ffs97/ta202-iitk-project/README.md

# TA202-IITK-Project
TA202 IITK 4th Semester Project, based on Smart Car Parking. Project Files include Isometric and Part Drawings, Inventor Files and Final Report for the TA202 IITK Project.
