ffs97/ta202-iitk-project/(list of files, cad)

Other CAD files:
Inventor Project/Inventor Drawing Files/Main Support.dwg
Inventor Project/Inventor Drawing Files/Main Assembly.dwg
Inventor Project/Inventor Drawing Files/Sprocket Shaft.dwg
Inventor Project/Inventor Drawing Files/Bed Axle.dwg
Inventor Project/Inventor Drawing Files/Angle.dwg
Inventor Project/Inventor Drawing Files/Worm Support.dwg
Inventor Project/Inventor Drawing Files/Handle Frame.dwg
Inventor Project/Inventor Drawing Files/Bed Plate Support.dwg
Inventor Project/Inventor Drawing Files/Handle Fix.dwg
Inventor Project/Inventor Drawing Files/Base Plate.dwg
Inventor Project/Inventor Drawing Files/Handle Holder.dwg
Inventor Project/Inventor Drawing Files/Worm Shaft.dwg
Inventor Project/Inventor Drawing Files/Bed Plate Hang.dwg
Inventor Project/Inventor Drawing Files/Bed Plate.dwg
Inventor Project/Inventor Drawing Files/Ramp.dwg
Inventor Project/Inventor Drawing Files/OldVersions/Main Assembly.0001_1.dwg
Inventor Project/Inventor Drawing Files/OldVersions/Handle Fix.0001.dwg
Inventor Project/Inventor Drawing Files/OldVersions/Bed Plate Hang.0001.dwg
Inventor Project/Angle.ipt
Inventor Project/Base Plate.ipt
Inventor Project/Bed Plate Assembly.iam
Inventor Project/Bed Plate Axle.ipt
Inventor Project/Bed Plate Hang.ipt
Inventor Project/Bed Plate Support.ipt
Inventor Project/Bed Plate.ipt
Inventor Project/Chain.ipt
Inventor Project/Handle Assembly.iam
Inventor Project/Handle Connected.ipt
Inventor Project/Handle Fix.ipt
Inventor Project/Handle Holder.ipt
Inventor Project/Inventor Drawing Files/OldVersions/Bed Plate.0001.dwg
Inventor Project/Main Assembly.iam
Inventor Project/Main Support.ipt
Inventor Project/Ramp.ipt
Inventor Project/Sprocket Axle.ipt
Inventor Project/Sprocket.ipt
Inventor Project/Worm Axle.ipt
Inventor Project/Worm Gear.ipt
Inventor Project/Worm Support.ipt
Inventor Project/Worm.ipt
