ffs97/ta202-iitk-project/Drawings/Handle Fix.pdf

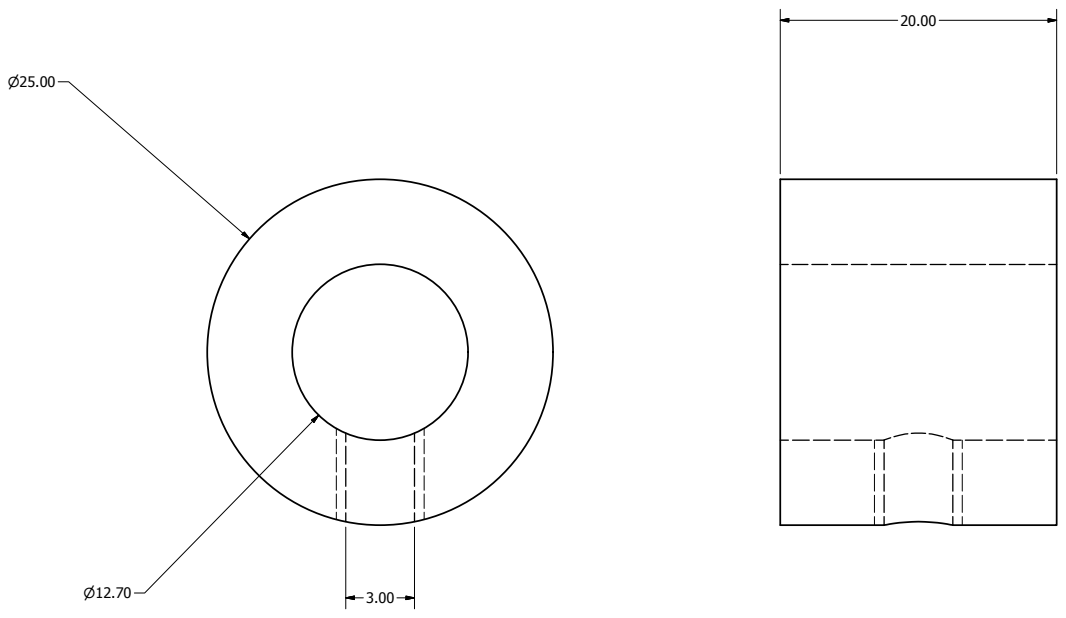
[picture p2: page 1]
Part No.; Quantity; Part Name; Handle Fix; Rod 22mm
