ffs97/ta202-iitk-project/Drawings/Bed Assembly.pdf

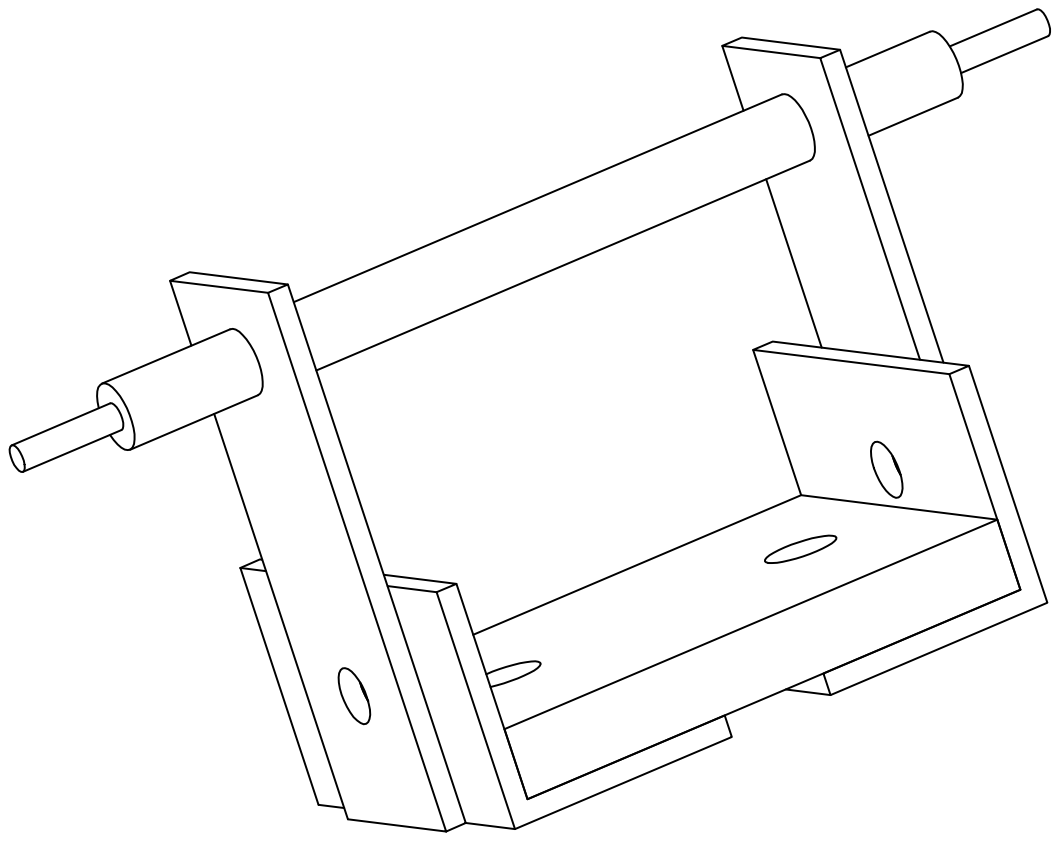
[picture p3: page 1]
Part No.; Quantity; Part Name; Bed Assembly
