ffs97/ta202-iitk-project/Drawings/Handle Assembly.pdf

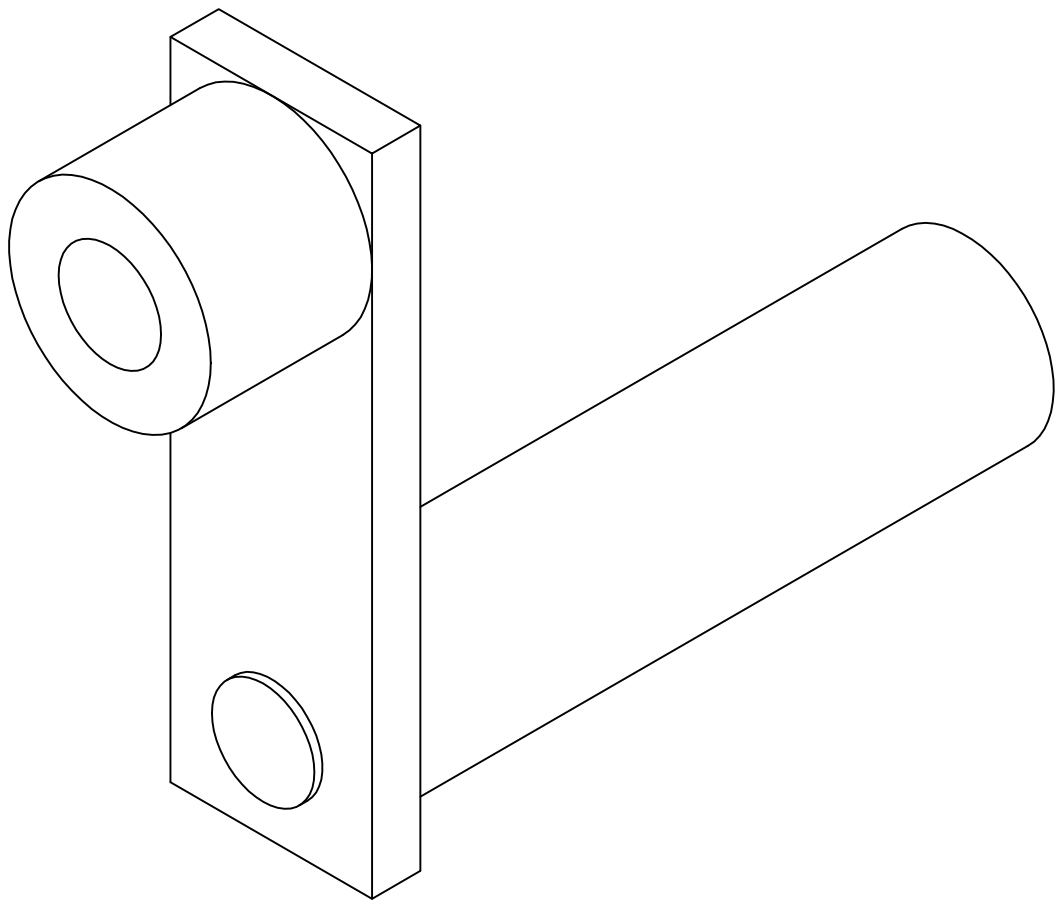
[picture p4: page 1]
Part No.; Quantity; Part Name; Handle Assembly
