ffs97/ta202-iitk-project/Drawings/Angle.pdf

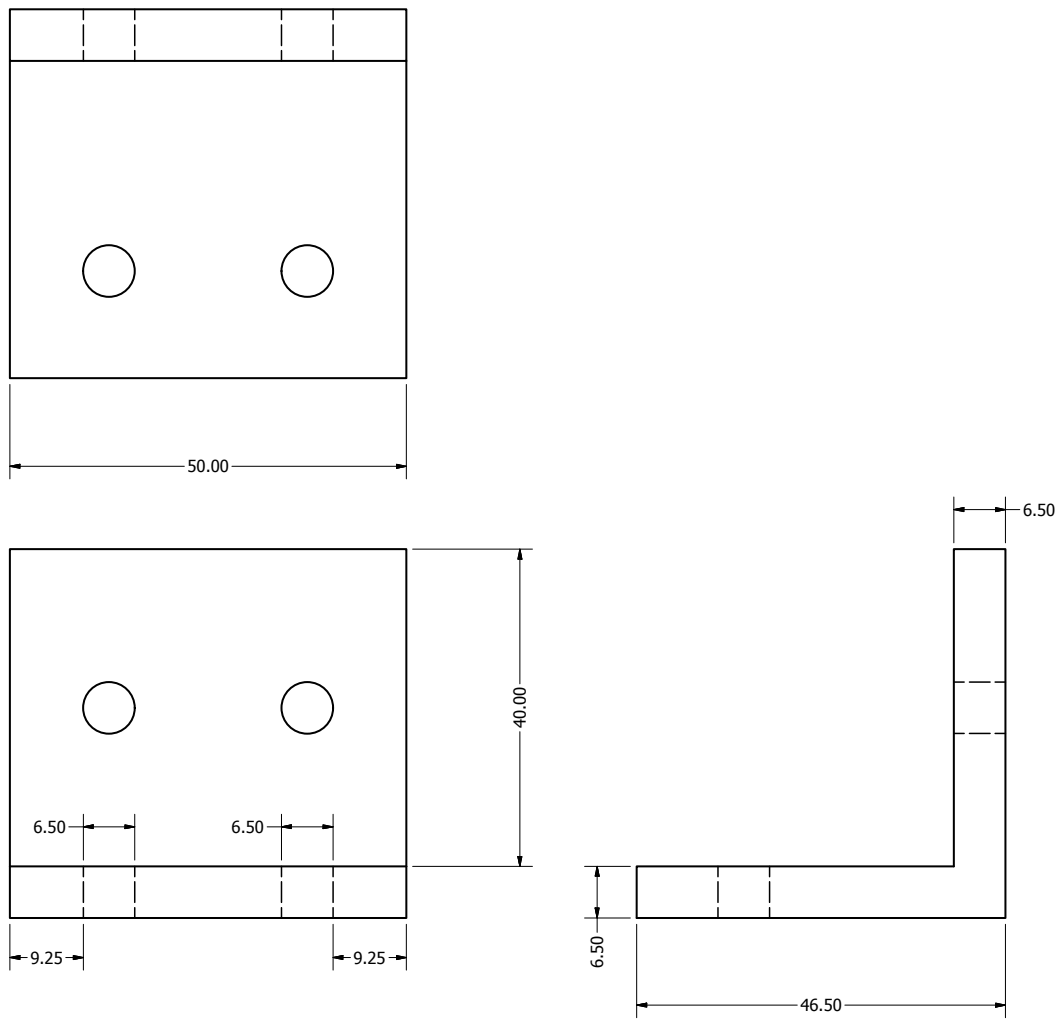
[picture p5: page 1]
Part No.; Quantity; Part Name; Angle; Flat 50mm x 50mm x
