ffs97/ta202-iitk-project/Drawings/Base Plate.pdf

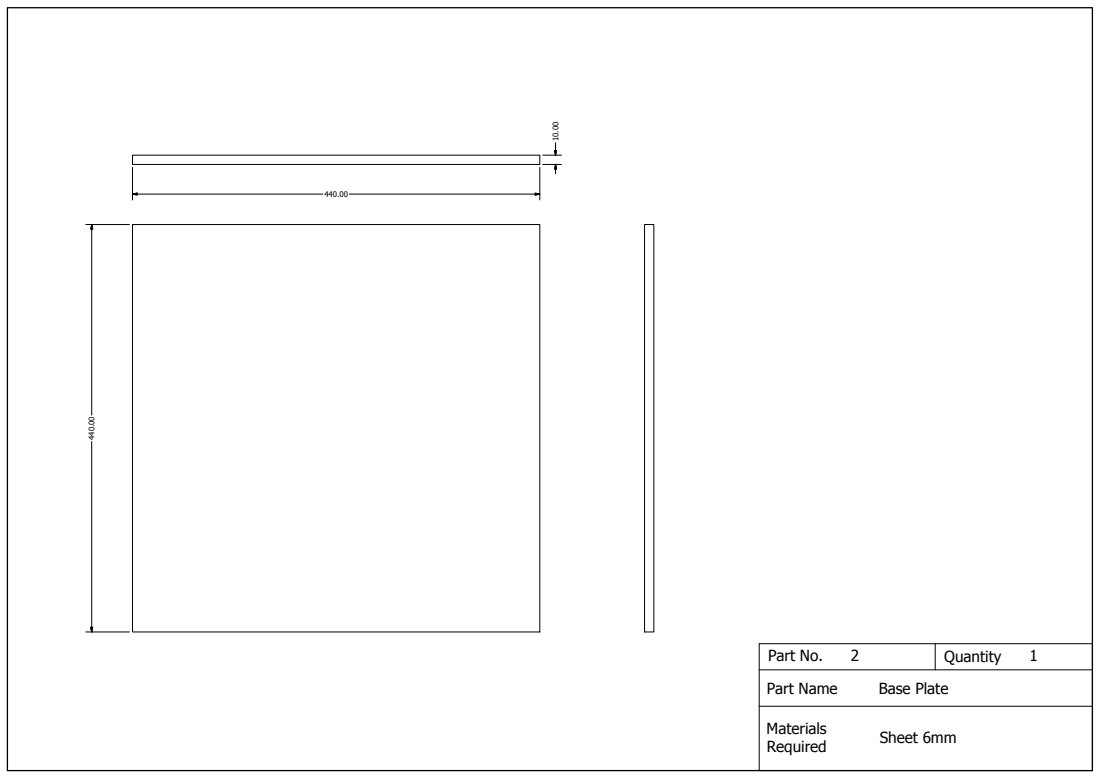
[picture p6: page 1]
Part No.; Quantity; Part Name; Base Plate; Sheet 6mm
