ffs97/ta202-iitk-project/Drawings/Bed Axle.pdf

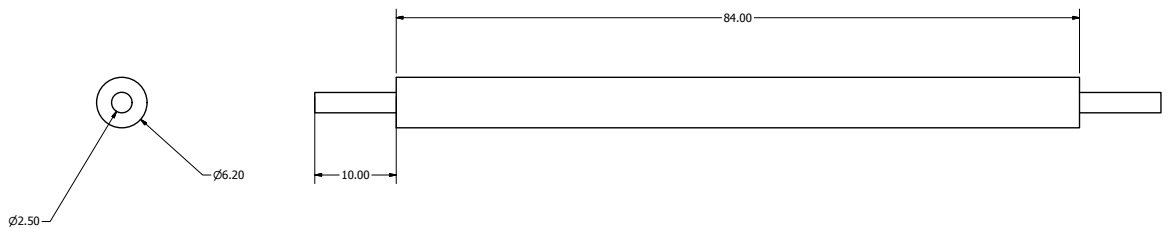
[picture p7: page 1]
Part No.; Quantity; Part Name; Bed Axle; Rod 6mm
