ffs97/ta202-iitk-project/Drawings/Bed Plate Hang.pdf

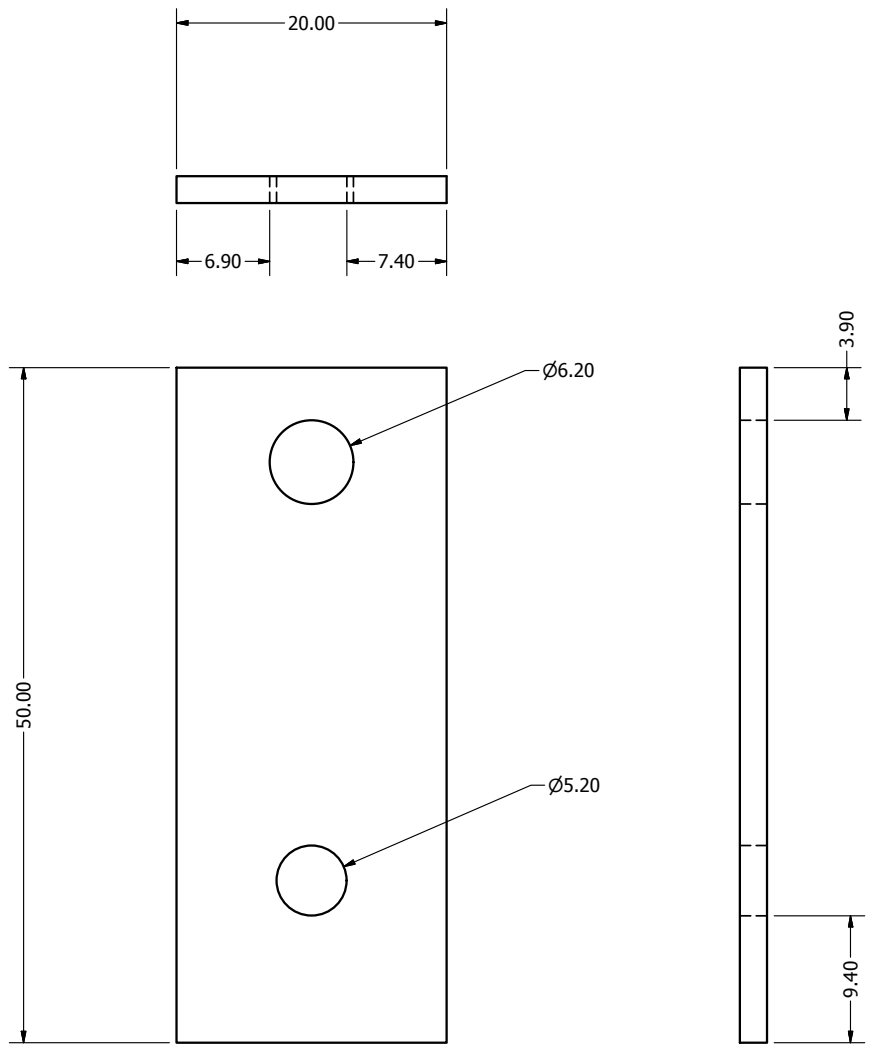
[picture p8: page 1]
Part No.; Quantity; Part Name; Bed Hang; Flat 2mm x 1mm
