ffs97/ta202-iitk-project/Drawings/Bed Plate Support.pdf

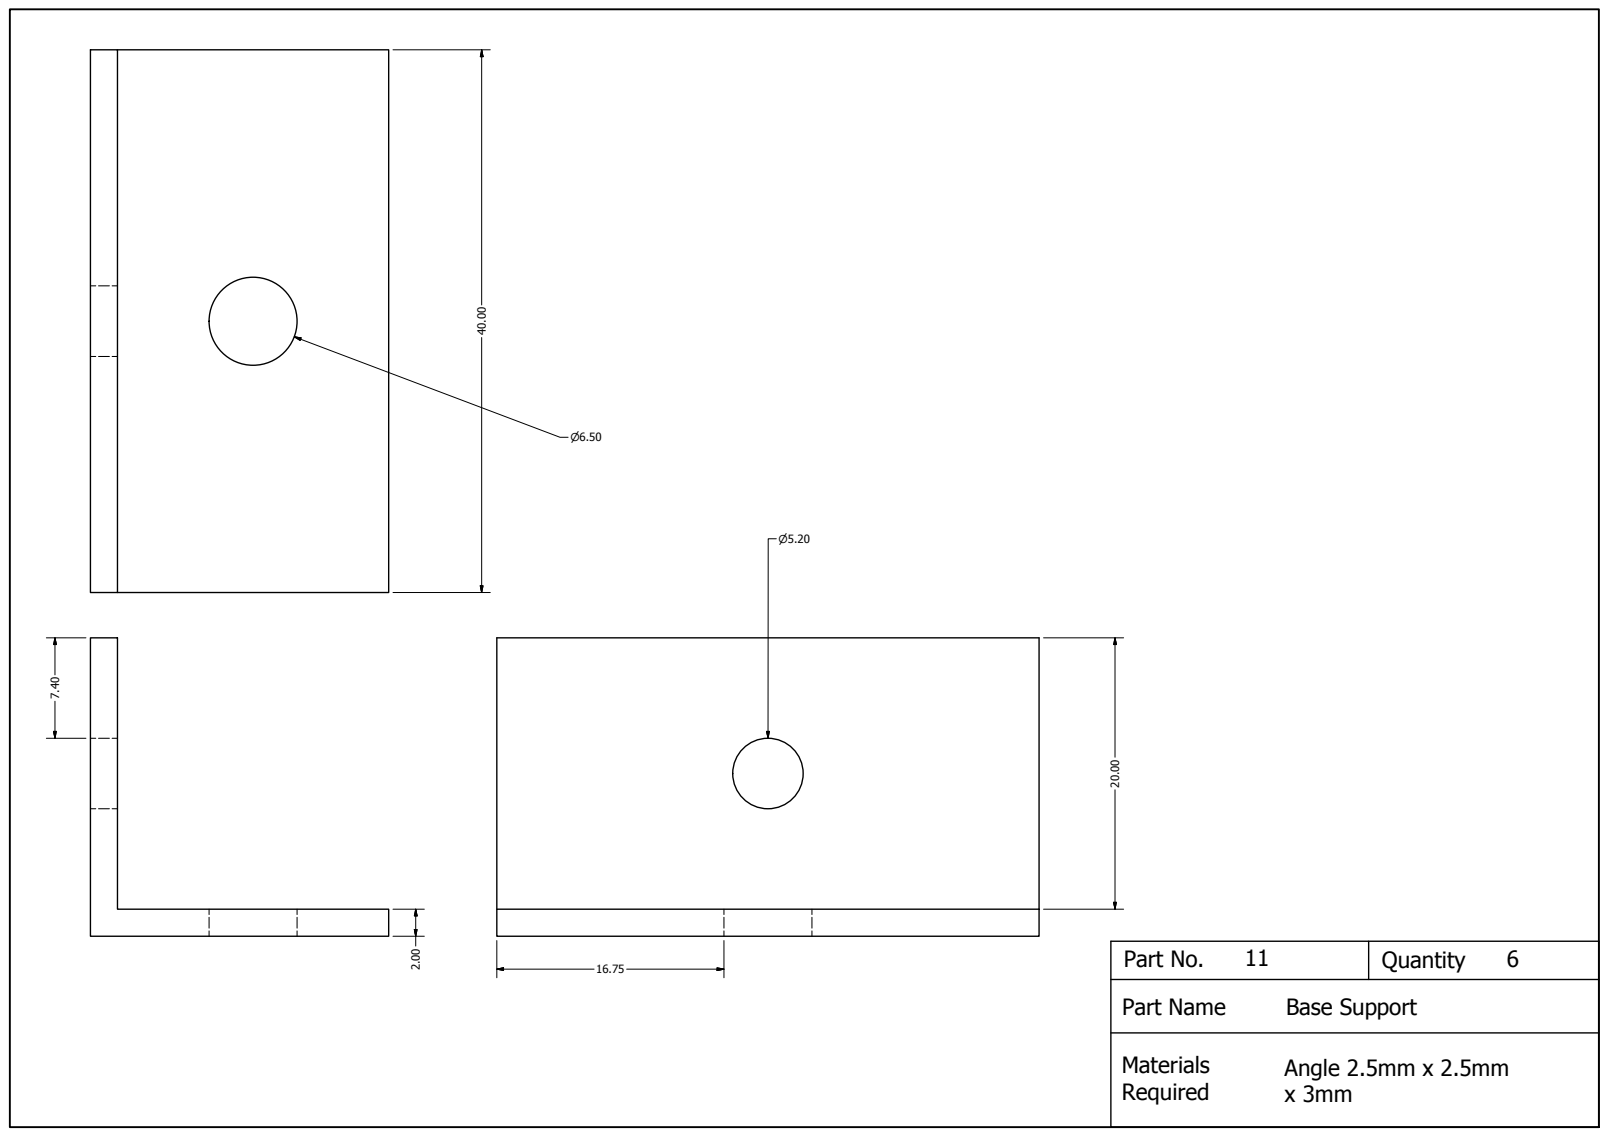
[picture p9: page 1]
Part No.; Quantity; Part Name; Base Support; Angle 2.5mm x 2.5mm x 3mm
