ffs97/ta202-iitk-project/Drawings/Bed Plate.pdf

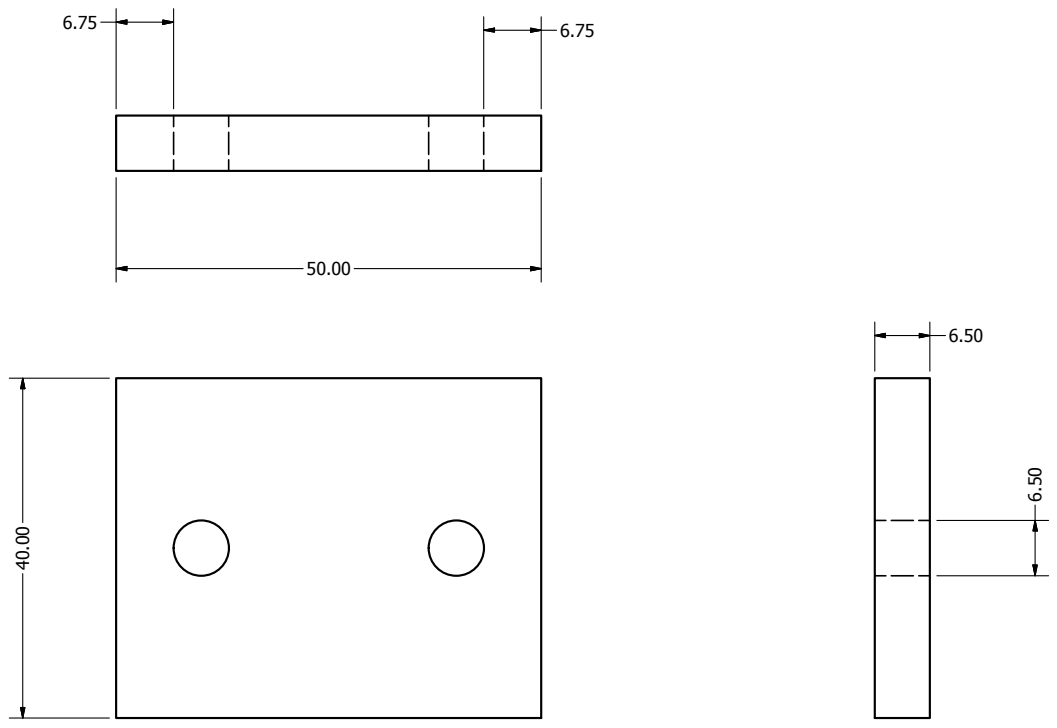
[picture p10: page 1]
Part No.; Quantity; Part Name; Bed Plate; Flat 50mm x 6.5mm
