ffs97/ta202-iitk-project/Drawings/Handle Frame.pdf

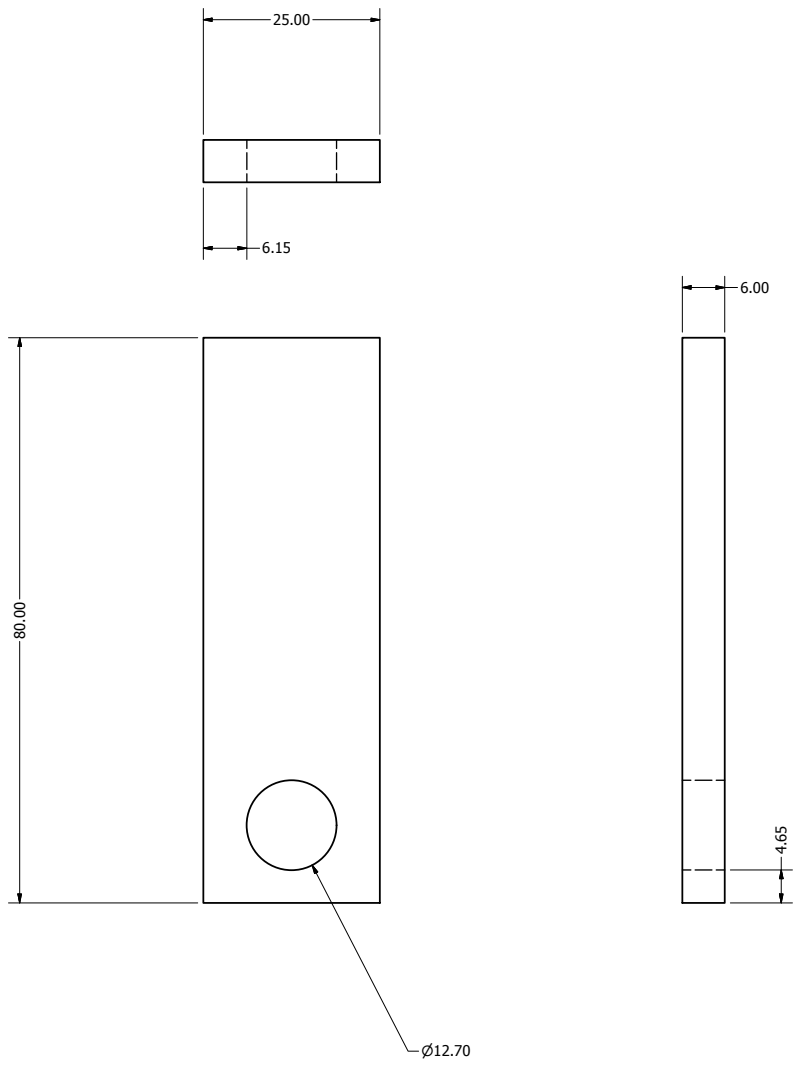
[picture p11: page 1]
Part No.; Quantity; Part Name; Handle Frame; Flat 22mm x 3mm
