ffs97/ta202-iitk-project/Drawings/Handle Holder.pdf

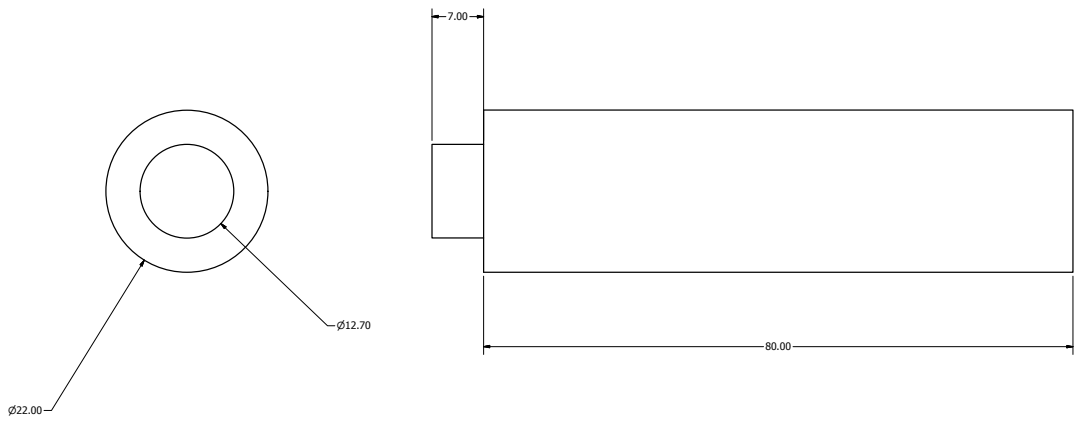
[picture p12: page 1]
Part No.; Quantity; Part Name; Handle Holder; Rod 22mm
