ffs97/ta202-iitk-project/Drawings/Main Frame Support.pdf

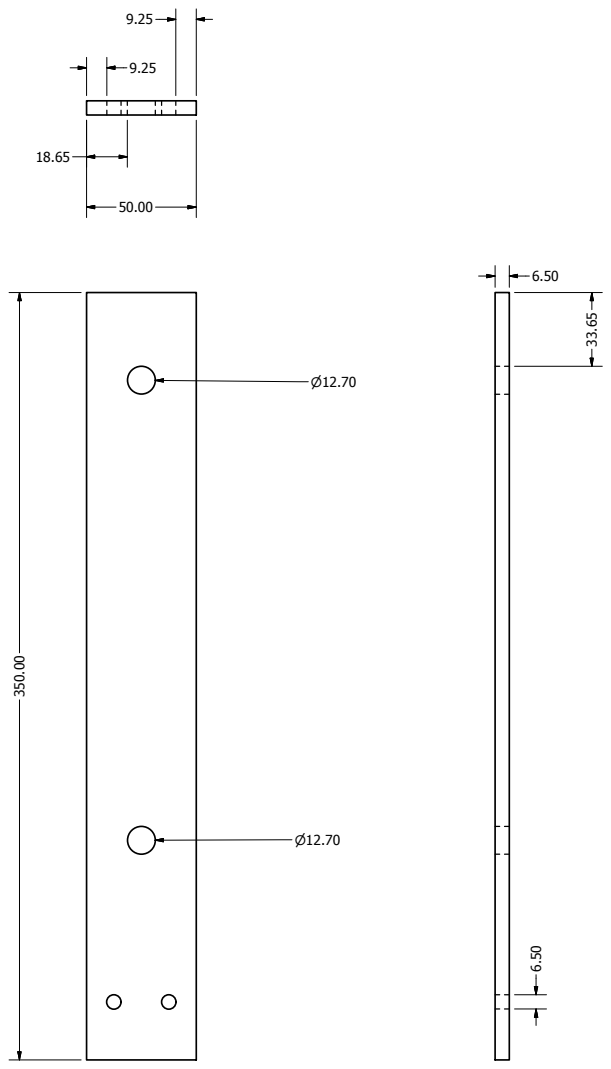
[picture p13: page 1]
Part No.; Quantity; Part Name; Main Frame Support; Flat 50mm x 6.5mm
