ffs97/ta202-iitk-project/Drawings/Ramp.pdf

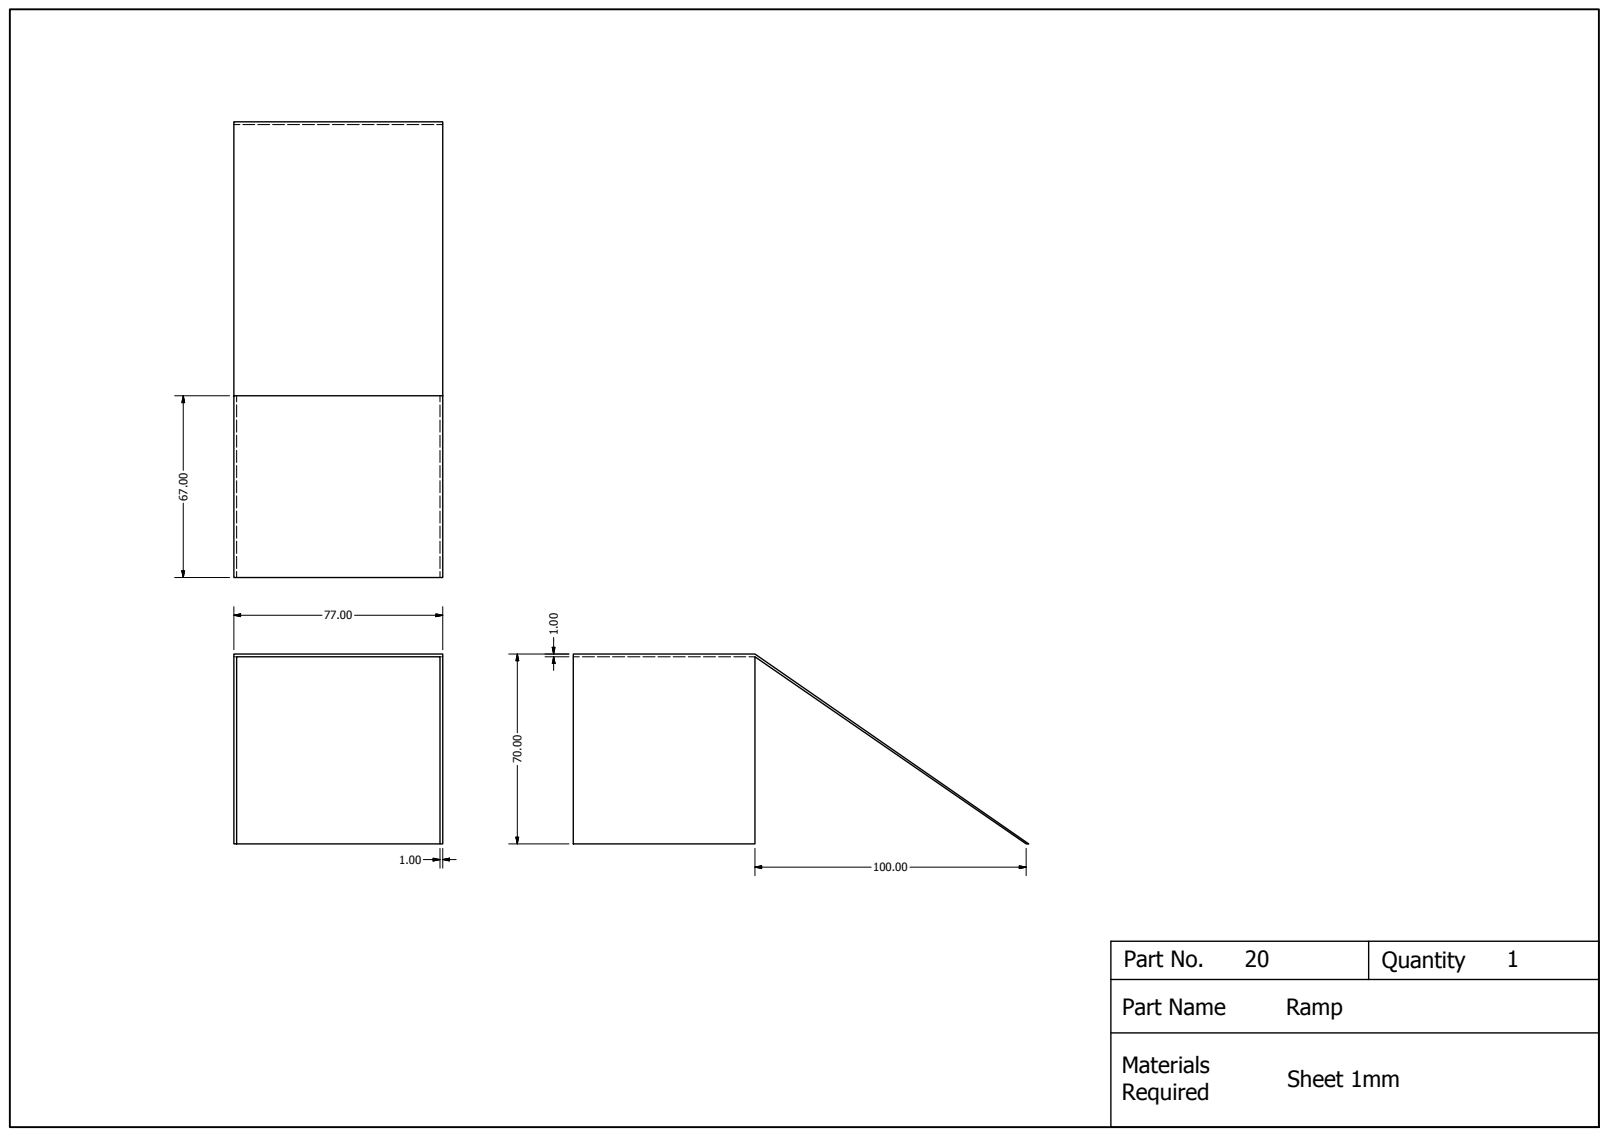
[picture p14: page 1]
Part No.; Quantity; Part Name; Ramp; Sheet 1mm
