ffs97/ta202-iitk-project/Drawings/Sprocket Shaft.pdf

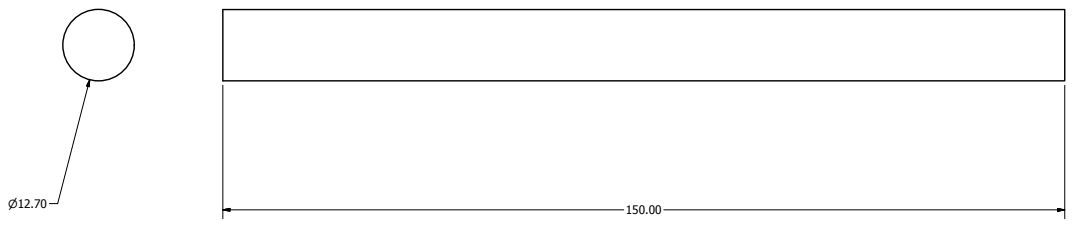
[picture p15: page 1]
Part No.; Quantity; Part Name; Sprocket Shaft; Rod 1/2''
