ffs97/ta202-iitk-project/Drawings/Worm Shaft.pdf

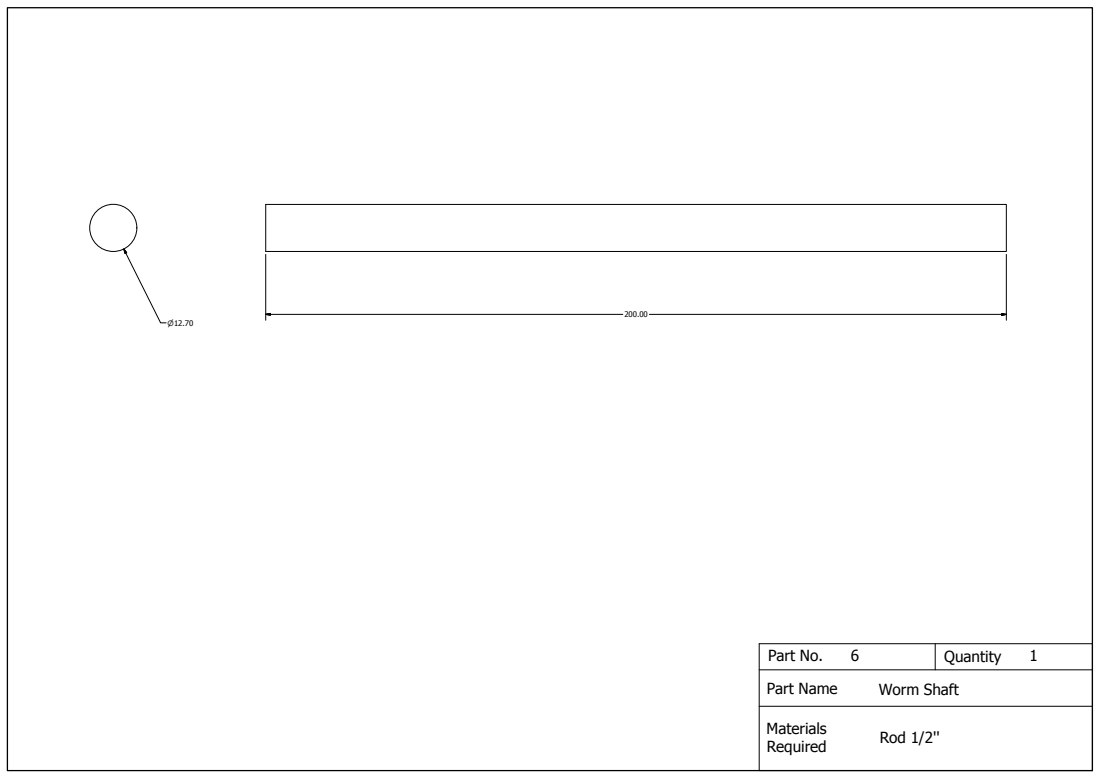
[picture p16: page 1]
Part No.; Quantity; Part Name; Worm Shaft; Rod 1/2''
