ffs97/ta202-iitk-project/Drawings/Worm Support.pdf

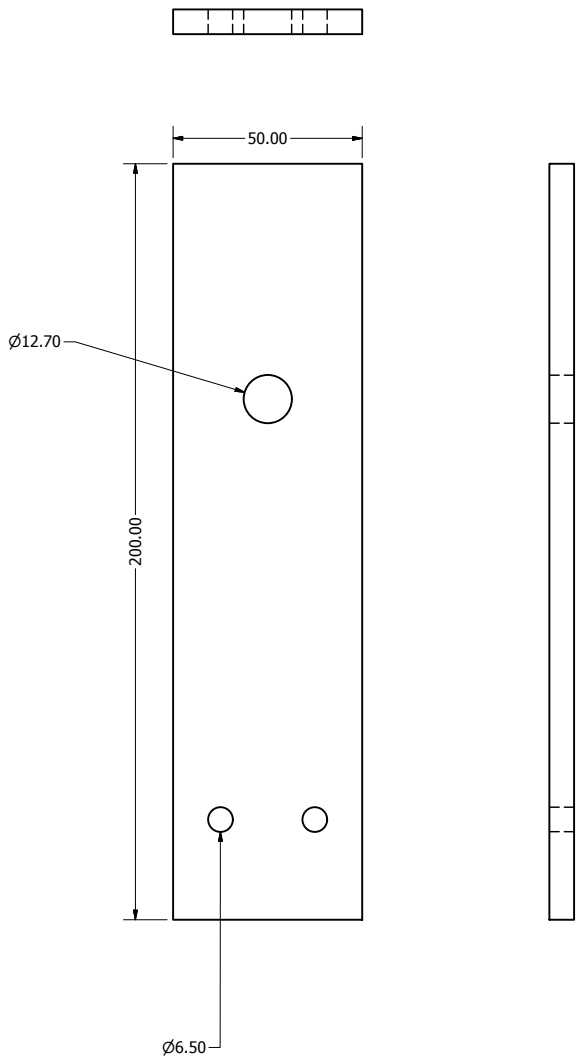
[picture p17: page 1]
Part No.; Quantity; Part Name; Worm Support; Flat 50mm x 6.5mm
