ffs97/ta202-iitk-project/Drawings/Isometric Drawing.pdf

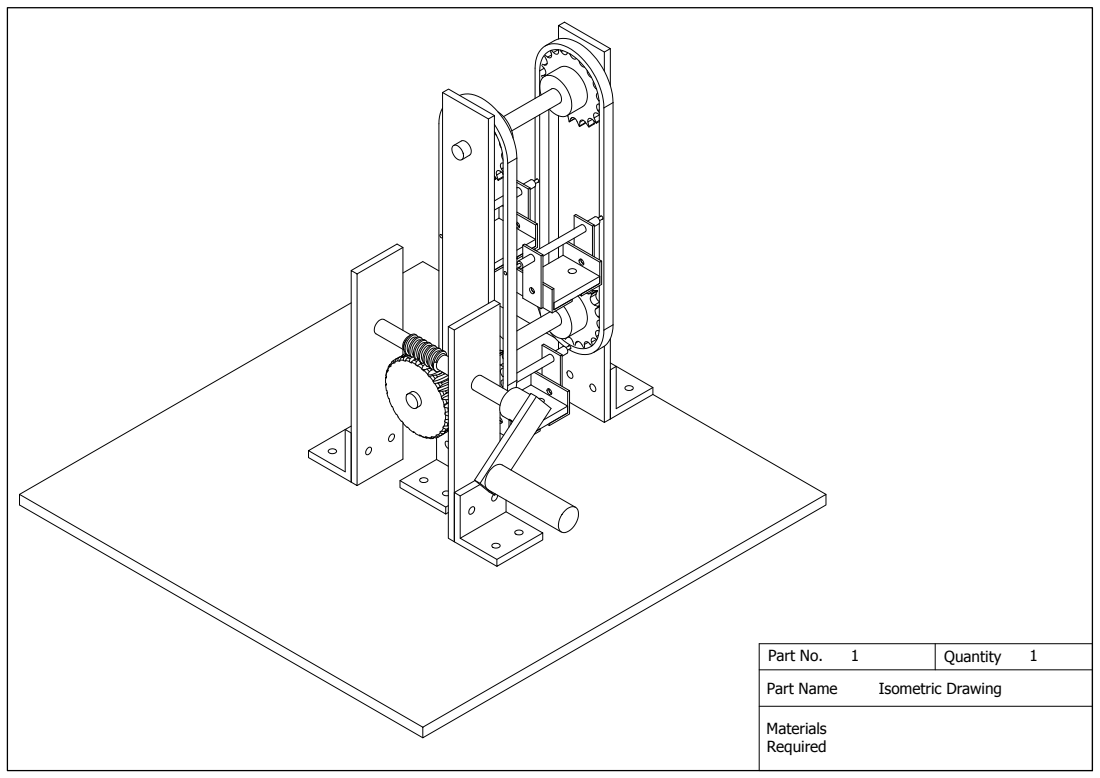
[picture p18: page 1]
Part No.; Quantity; Part Name; Isometric Drawing
